zolee1209/ESP32_CapacitiveMoistureSensor/scope_measurements/dry_40MHz_before_diode.png

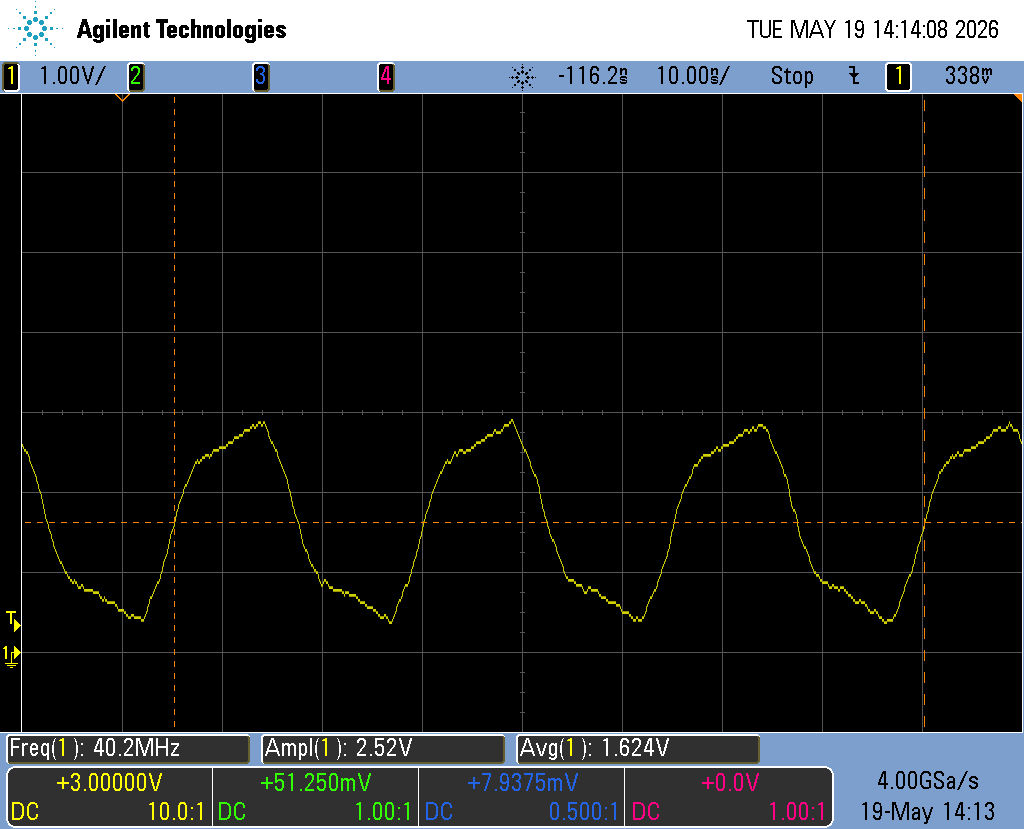
scope_measurements/dry_40MHz_before_diode.png
