zolee1209/ESP32_CapacitiveMoistureSensor/scope_measurements/dry_1250kHz_before_diode.png

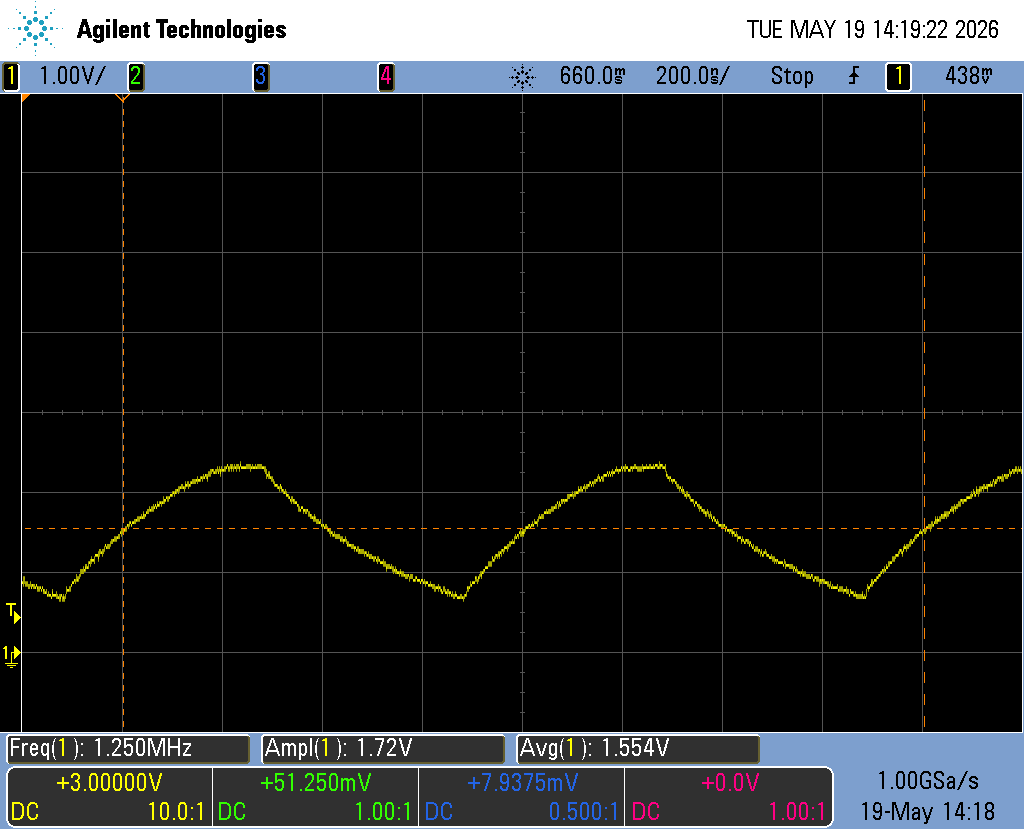
scope_measurements/dry_1250kHz_before_diode.png
