zolee1209/ESP32_CapacitiveMoistureSensor/scope_measurements/dry_before_diode_full.png

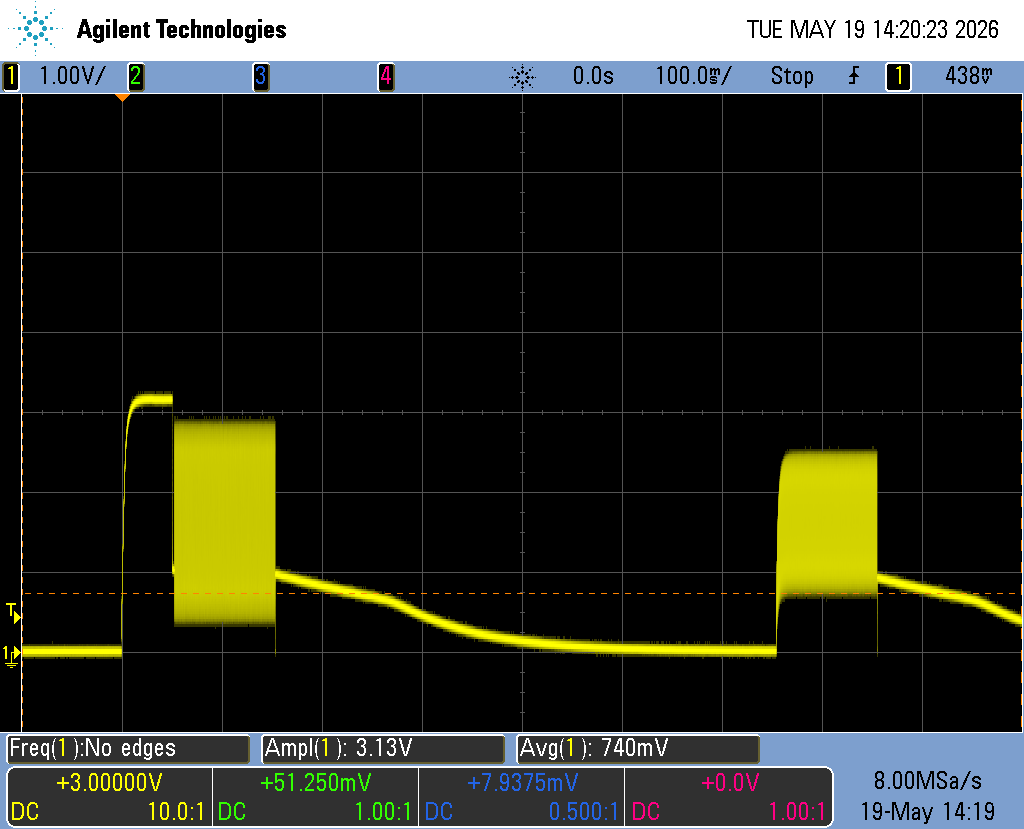
scope_measurements/dry_before_diode_full.png
