zolee1209/ESP32_CapacitiveMoistureSensor/scope_measurements/dry_GPIO6_full.png

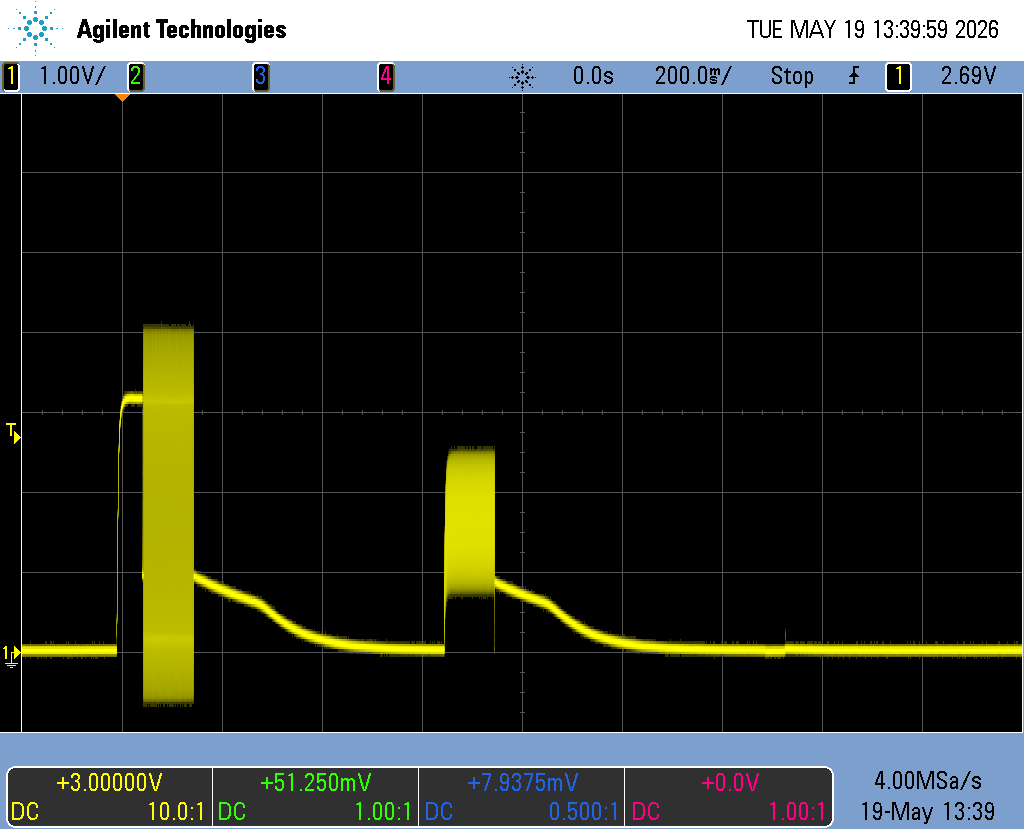
scope_measurements/dry_GPIO6_full.png
