zolee1209/ESP32_CapacitiveMoistureSensor/scope_measurements/dry_GPIO7_zoom.png

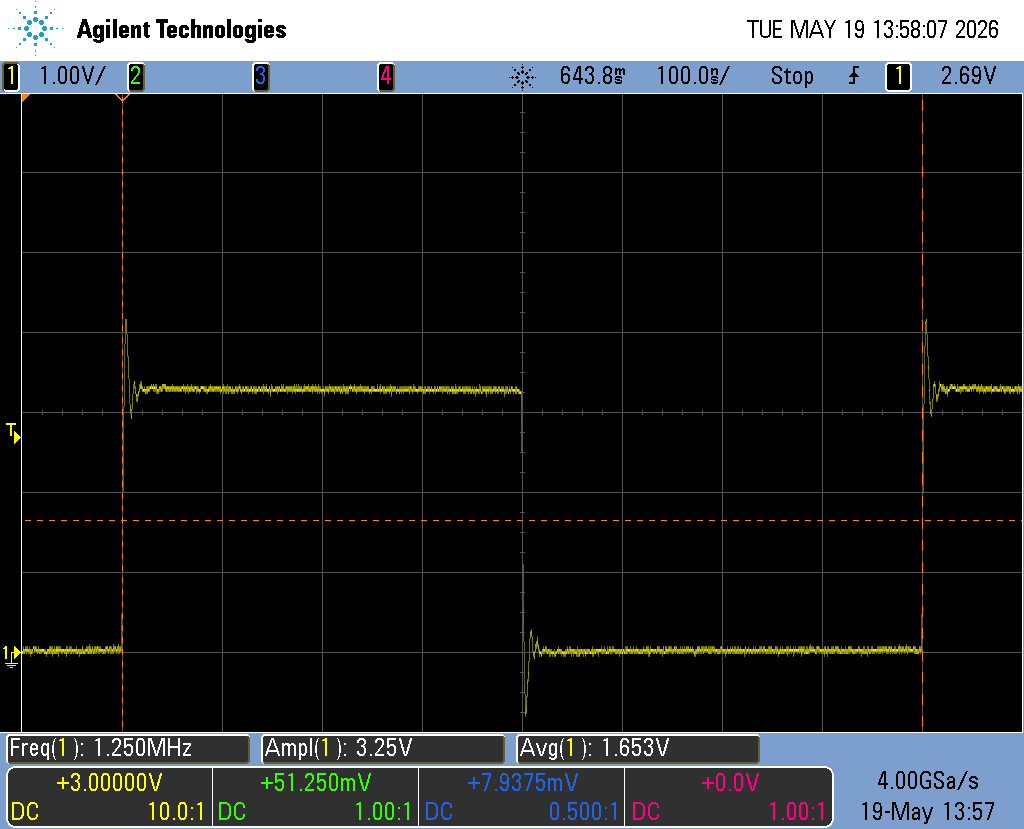
scope_measurements/dry_GPIO7_zoom.png
