zolee1209/ESP32_CapacitiveMoistureSensor/scope_measurements/wet_40MHz_before_diode.png

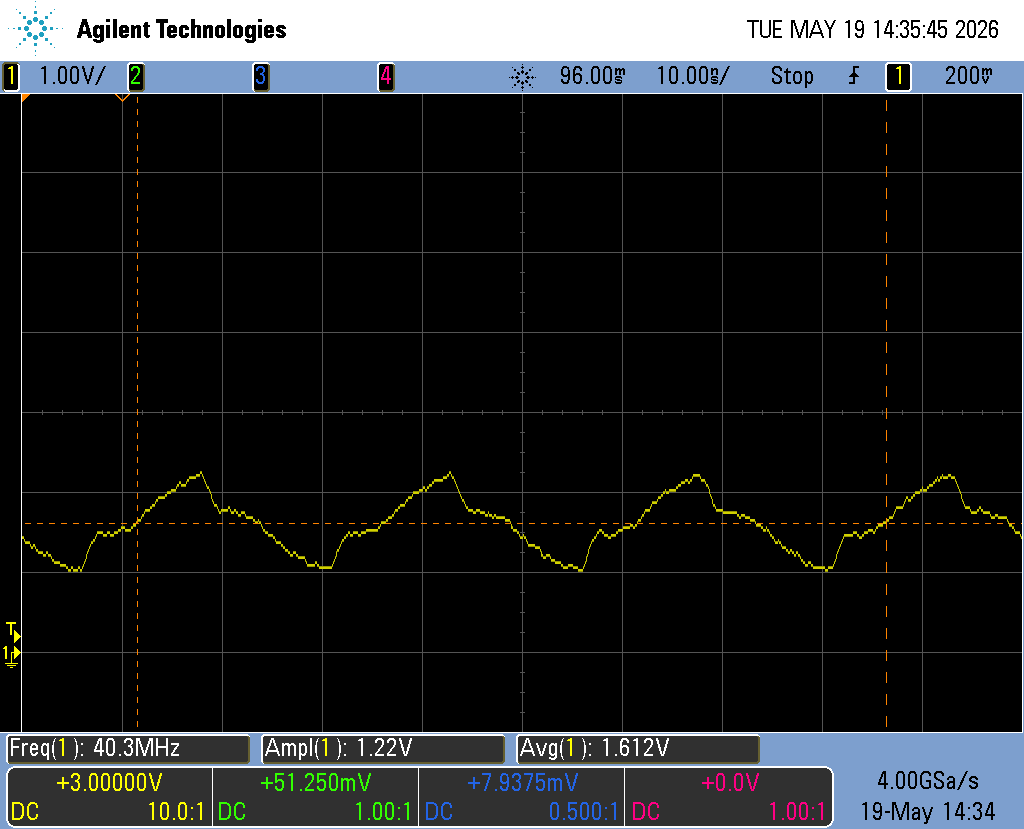
scope_measurements/wet_40MHz_before_diode.png
