zolee1209/ESP32_CapacitiveMoistureSensor/scope_measurements/wet_1250kHz_before_diode.png

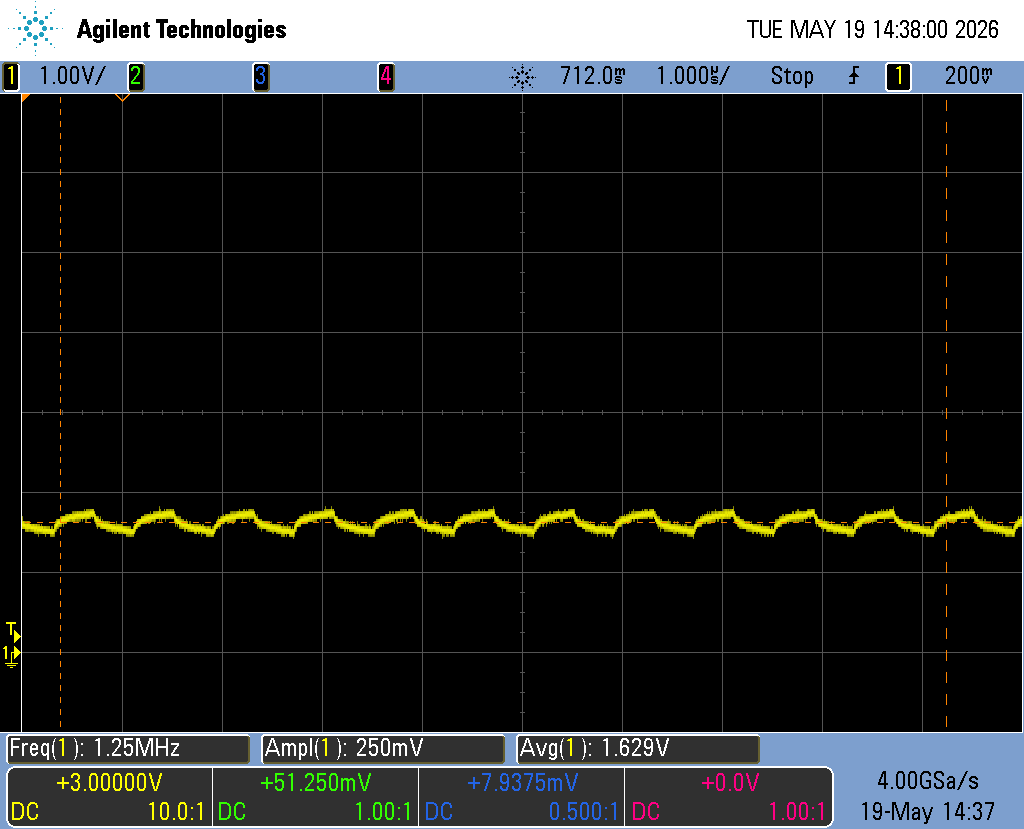
scope_measurements/wet_1250kHz_before_diode.png
