zolee1209/ESP32_CapacitiveMoistureSensor/scope_measurements/wet_after_diode_full.png

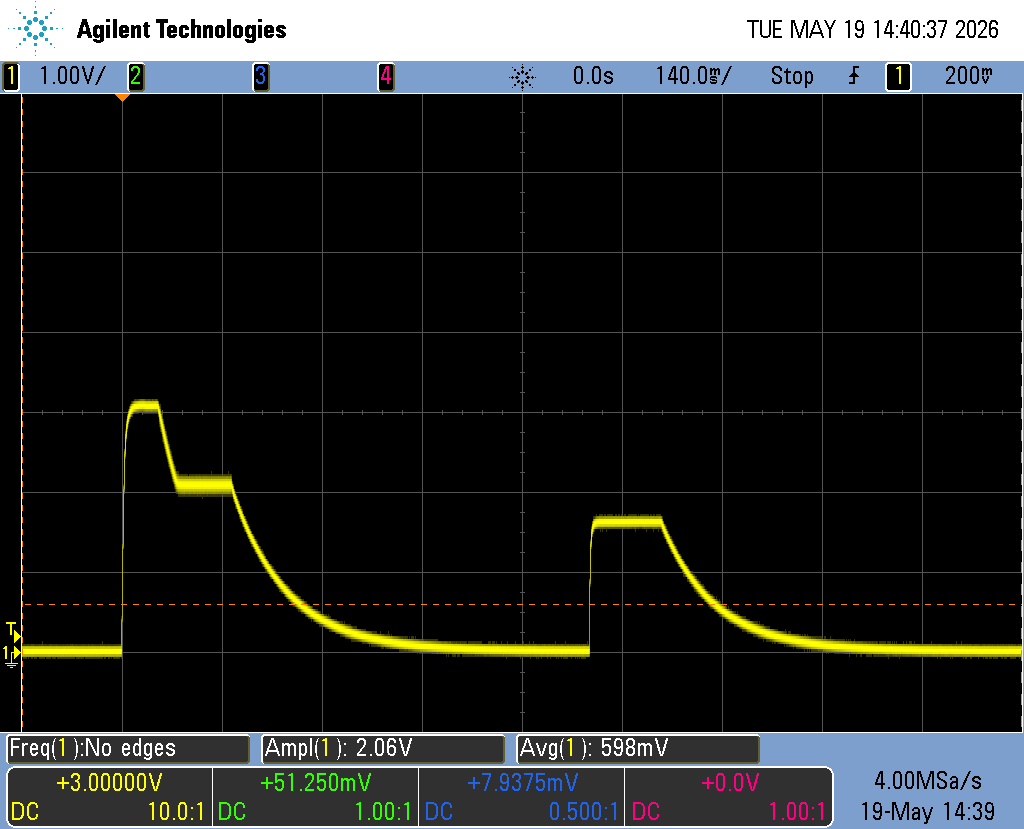
scope_measurements/wet_after_diode_full.png
