zolee1209/ESP32_CapacitiveMoistureSensor/scope_measurements/wet_GPIO6_zoom.png

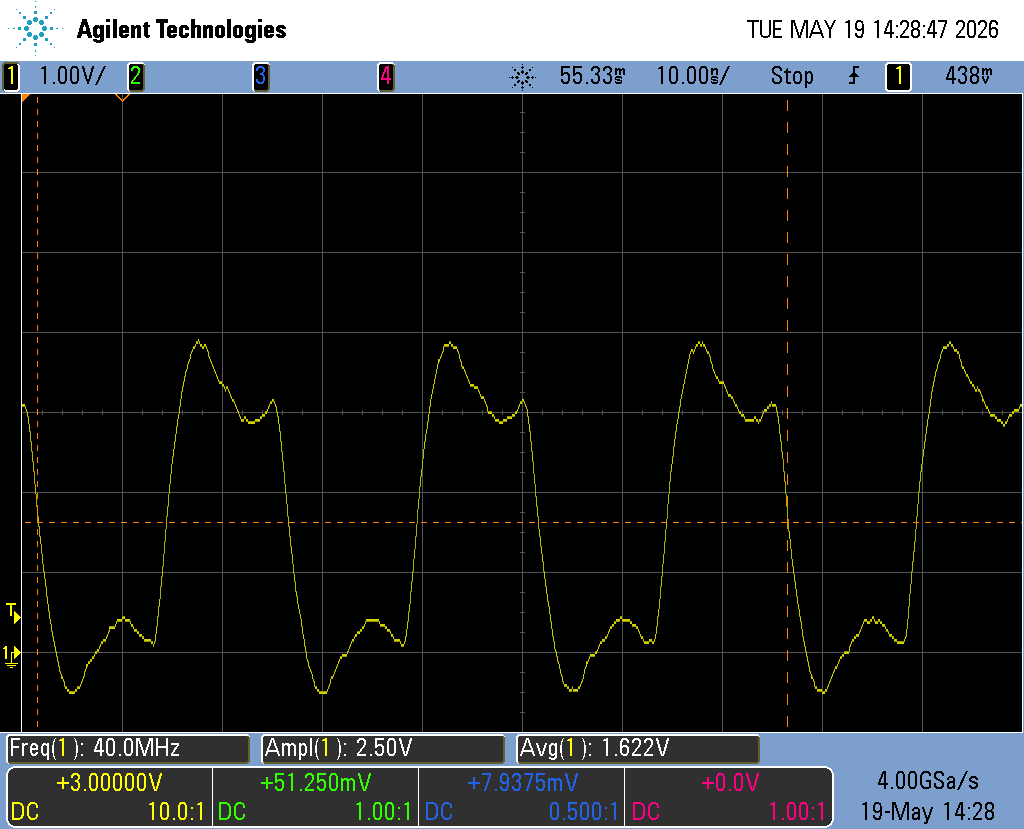
scope_measurements/wet_GPIO6_zoom.png
