zolee1209/ESP32_CapacitiveMoistureSensor/scope_measurements/wet_GPIO7_full.png

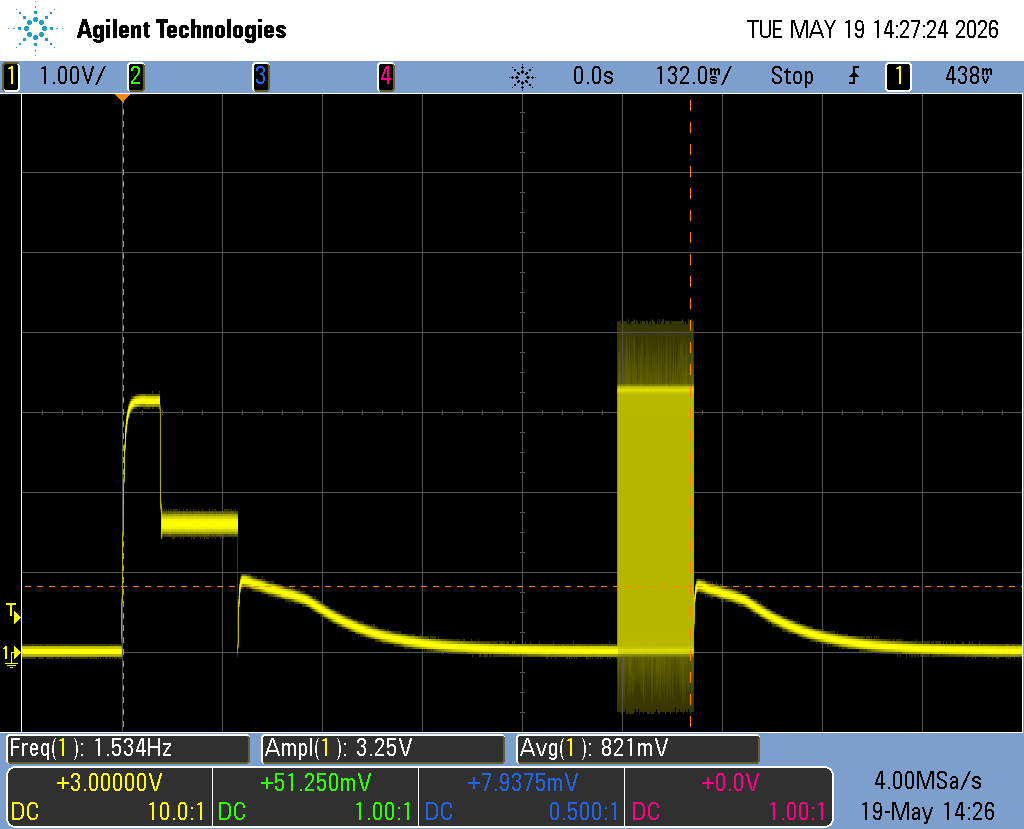
scope_measurements/wet_GPIO7_full.png
